asredni/Microgravity-Clinostat/NEMA 17.SLDASM

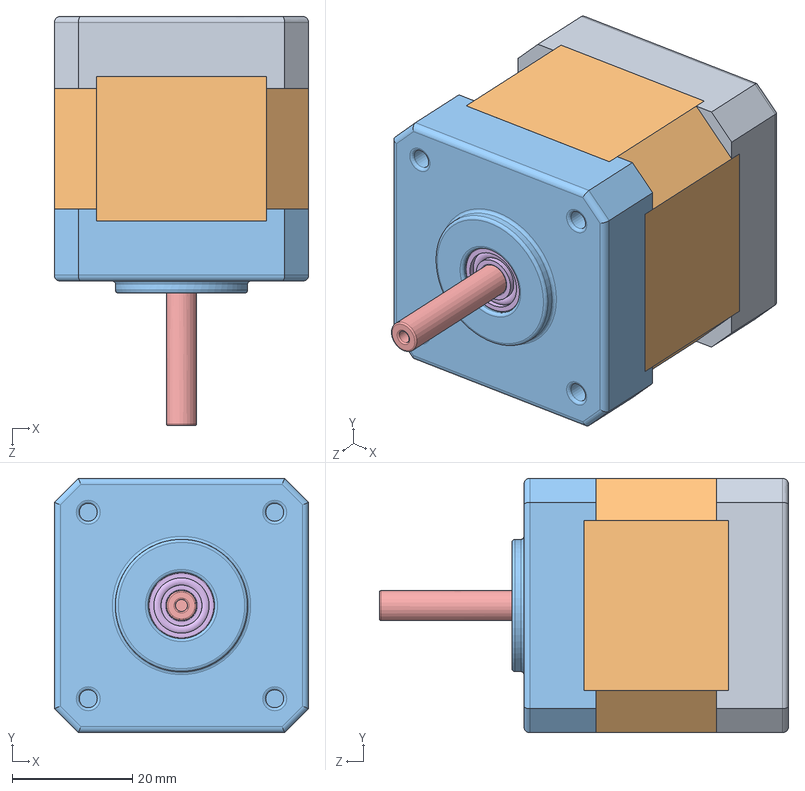
[picture p17: CAD file, 2019-08-01]
NEMA 17.SLDASM
42.3 x 42.3 x 68.0 mm
Base
Cuerpo
Tapa
pan cross head_am x 4
Eje
instrument ball bearing_68_am x 2
