asredni/Microgravity-Clinostat/Montagem1.SLDASM

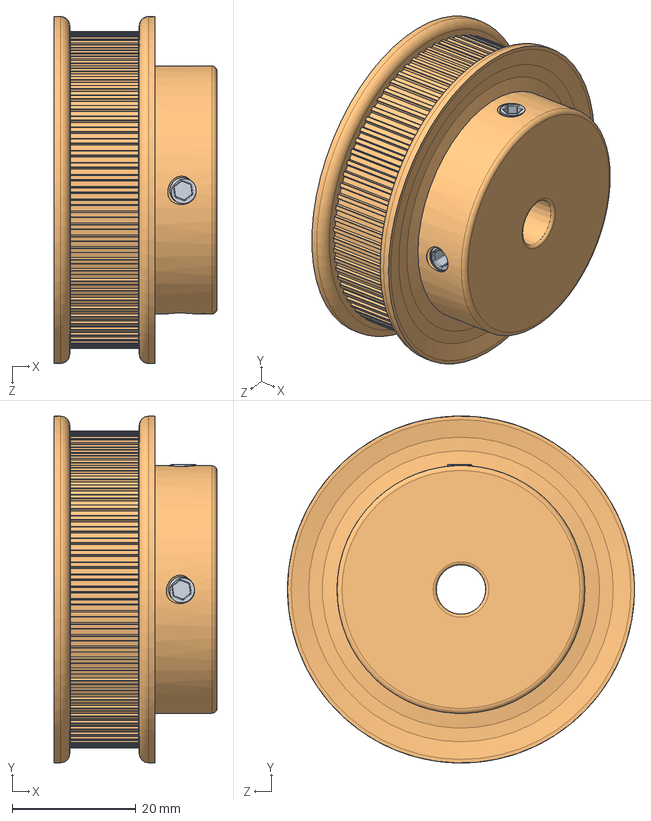
[picture p18: CAD file, 2019-08-01]
Montagem1.SLDASM
26.3 x 56.0 x 56.0 mm
setscrew M5 x 2
PULLEY MXL80 2mm
