asredni/Microgravity-Clinostat/assem semi-semi.SLDASM

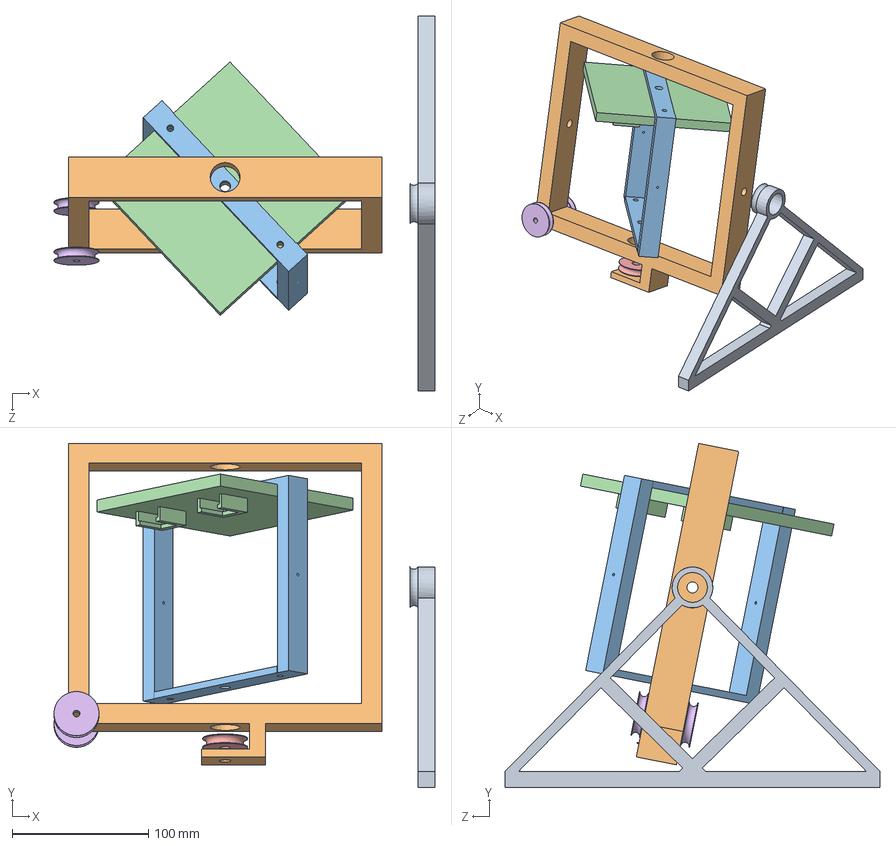
[picture p19: CAD file, 2019-08-01]
assem semi-semi.SLDASM
279.6 x 252.6 x 275.0 mm
Base truss
outer frame 4
inner frame, frame
Inner Frame Plate
27mm o-ring gear big
27mm o-ring gear real x 2
