asredni/Microgravity-Clinostat/Assem semi-final.SLDASM

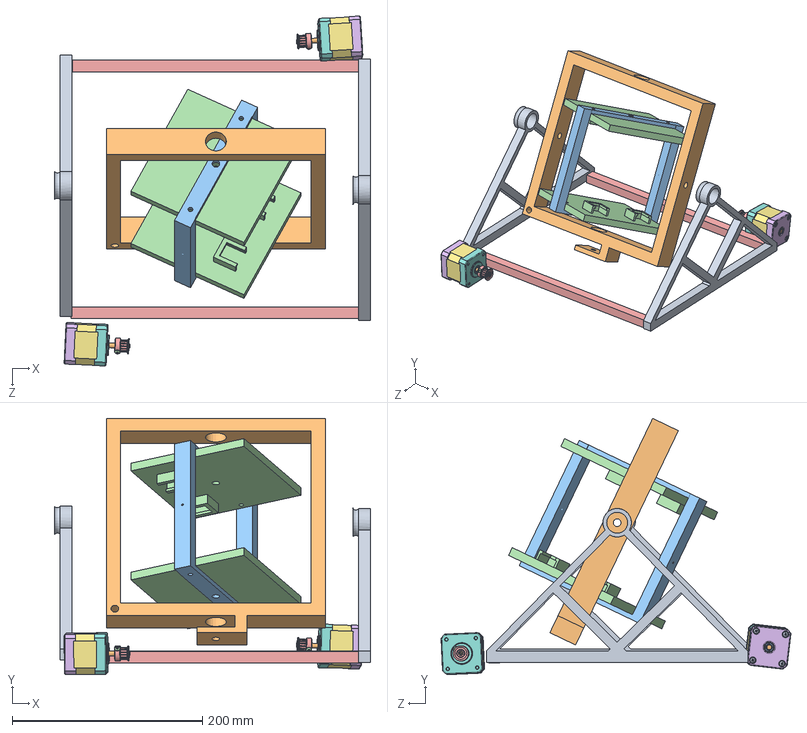
[picture p20: CAD file, 2019-08-01]
Assem semi-final.SLDASM
332.2 x 269.3 x 367.8 mm
Base truss x 2
outer frame 3
inner frame, frame
Inner Frame Plate x 2
outer frame beam x 2
Base x 2
Cuerpo x 2
Tapa x 2
pan cross head_am x 8
Eje x 2
instrument ball bearing_68_am x 4
socket button head cap screw_am x 2
T5 Pulley x 2
