asredni/Microgravity-Clinostat/aseembf.SLDASM

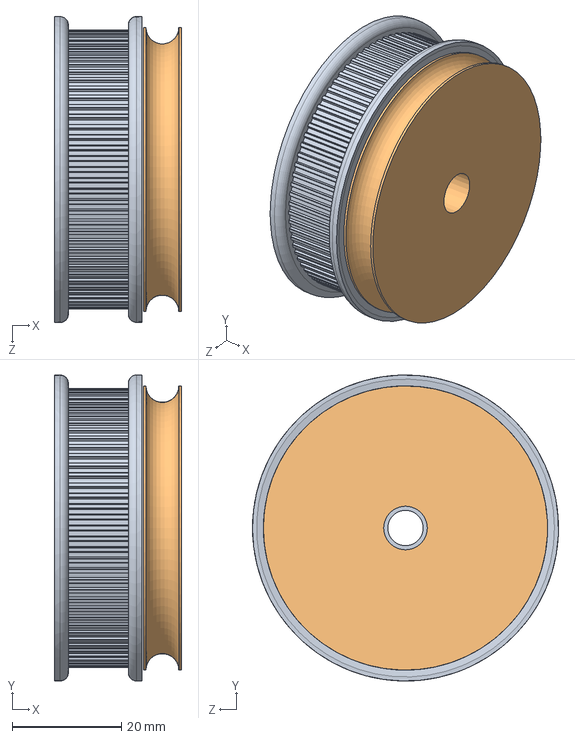
[picture p21: CAD file, 2019-08-01]
aseembf.SLDASM
23.2 x 56.0 x 56.0 mm
Outer gear pulley 4
46mm o-ring gear big
