asredni/Microgravity-Clinostat/assemb 5.SLDASM

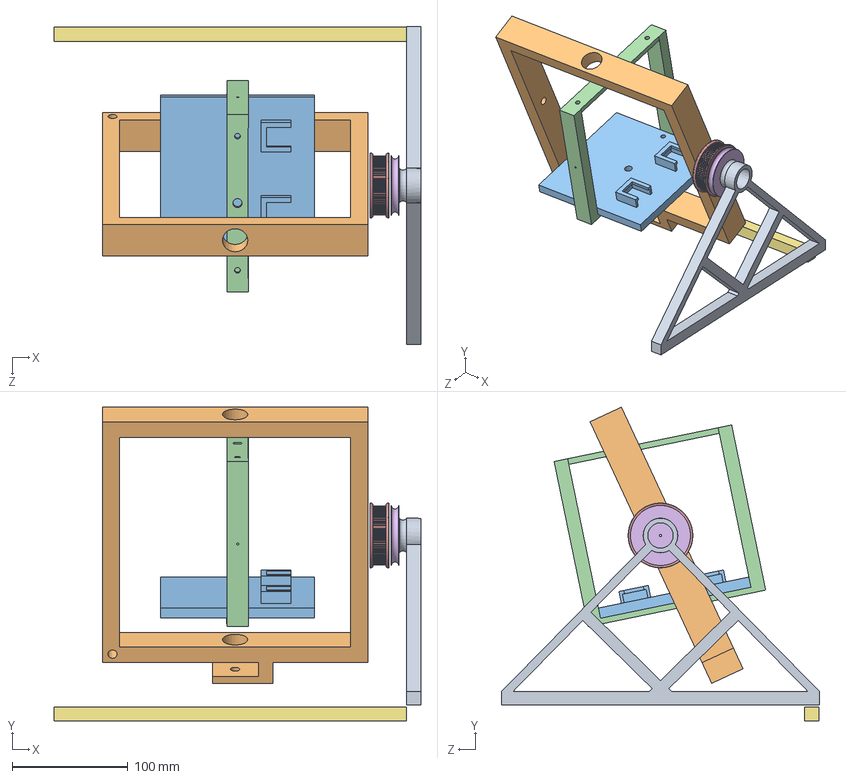
[picture p22: CAD file, 2019-08-01]
assemb 5.SLDASM
317.7 x 271.6 x 275.0 mm
Base truss
outer frame 3
Inner Frame Plate
inner frame, frame
Outer frame pulley 2
46mm o-ring gear (2)
outer base beam
