asredni/Microgravity-Clinostat/assemb 4.SLDASM

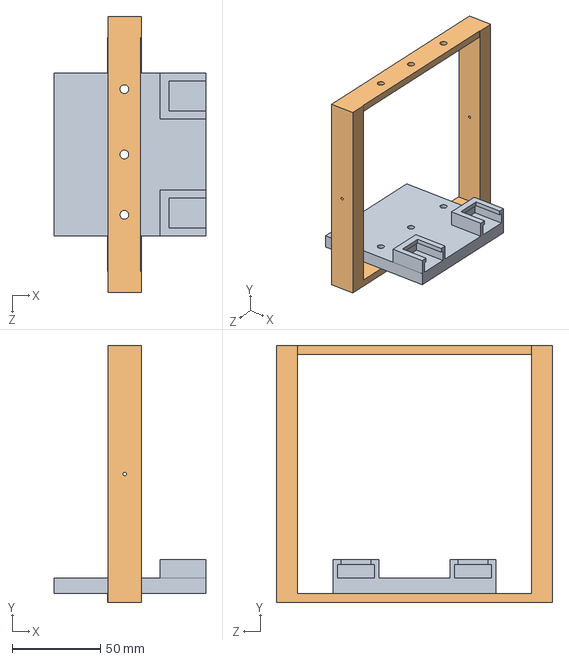
[picture p23: CAD file, 2019-08-01]
assemb 4.SLDASM
86.1 x 146.0 x 157.0 mm
Inner Frame Plate 2
inner frame, frame, holes 2
