asredni/Microgravity-Clinostat/ewg.SLDASM

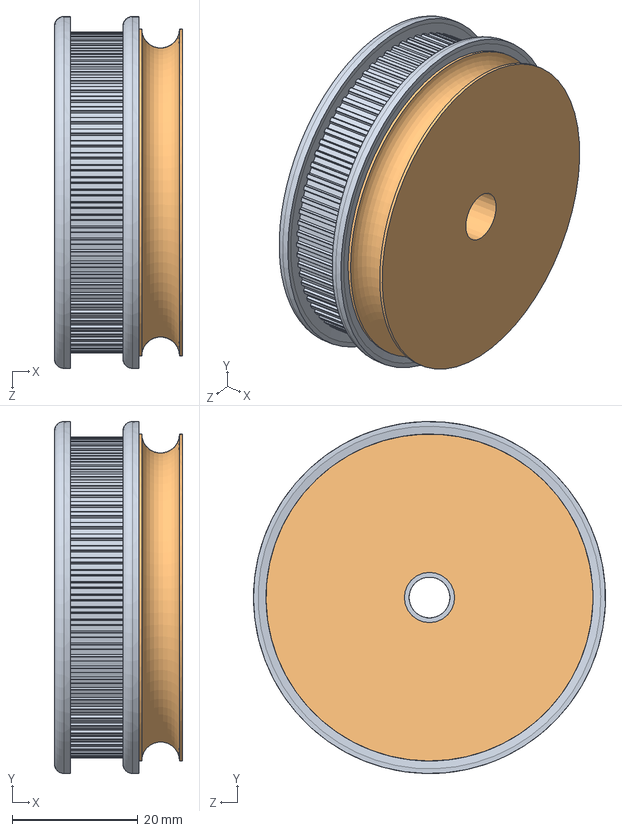
[picture p24: CAD file, 2019-08-01]
ewg.SLDASM
20.4 x 56.0 x 56.0 mm
outer gear small
46mm o-ring gear big
