asredni/Microgravity-Clinostat/Assem2.SLDASM

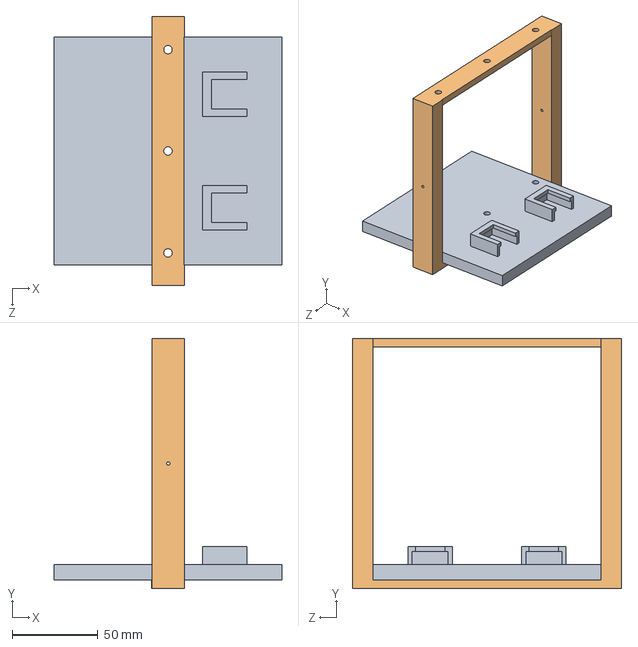
[picture p25: CAD file, 2019-08-01]
Assem2.SLDASM
133.0 x 146.0 x 157.0 mm
Inner Frame Plate
inner frame, frame
