asredni/Microgravity-Clinostat/engclamp.SLDASM

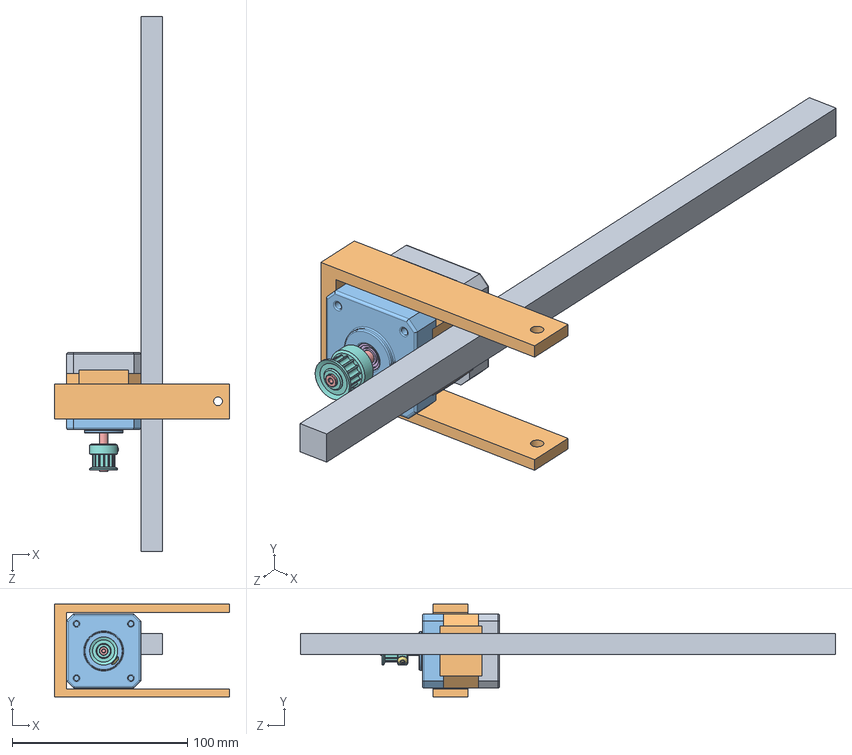
[picture p26: CAD file, 2019-08-01]
engclamp.SLDASM
100.0 x 53.0 x 305.0 mm
Base
Cuerpo
Tapa
pan cross head_am x 4
Eje
instrument ball bearing_68_am x 2
socket button head cap screw_am
T5 Pulley
outer frame beam
engine clamp
