asredni/Microgravity-Clinostat/RPM assemb 4.SLDASM

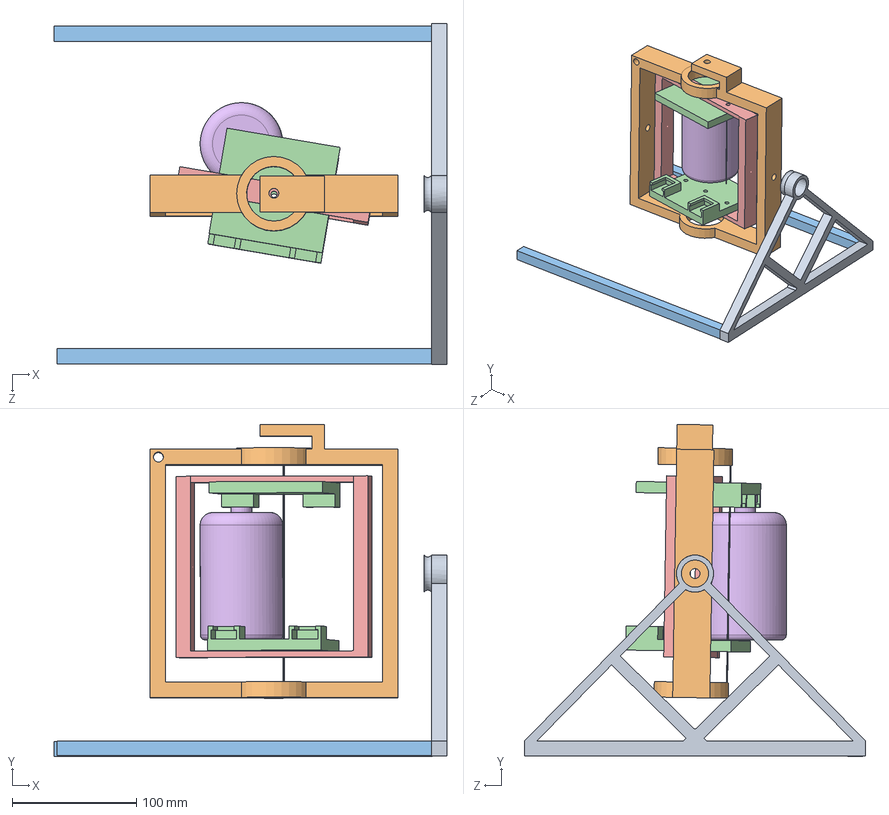
[picture p27: CAD file, 2019-08-01]
RPM assemb 4.SLDASM
316.7 x 267.7 x 275.0 mm
Base truss
outer frame 2
outer frame beam x 2
Inner Frame Plate 2 x 2
inner frame, frame, holes 2
sciencebottle (1)
