asredni/Microgravity-Clinostat/Outer Frame Pulley Edited.SLDASM

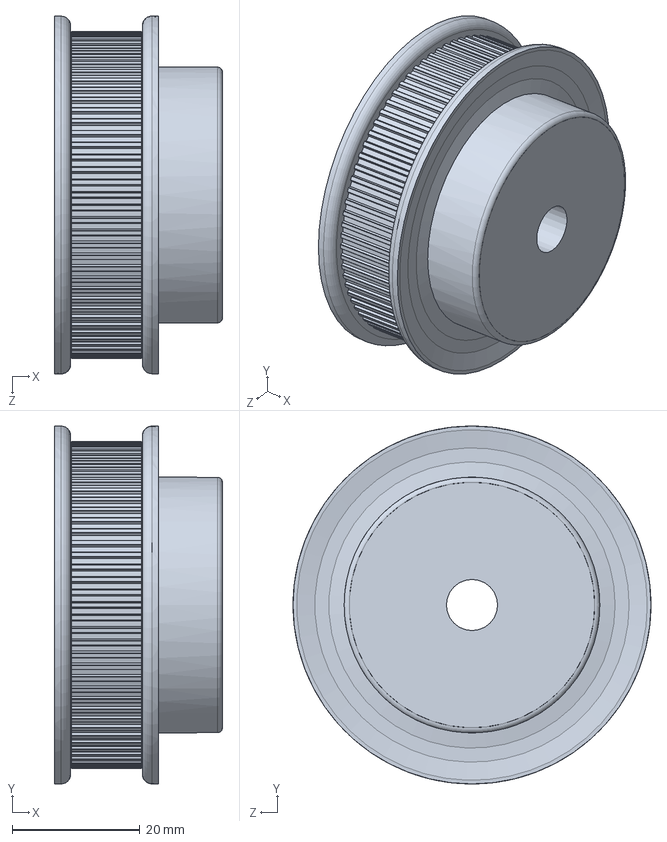
[picture p28: CAD file, 2019-08-01]
Outer Frame Pulley Edited.SLDASM
26.3 x 56.0 x 56.0 mm
