asredni/Microgravity-Clinostat/gear merge.SLDASM

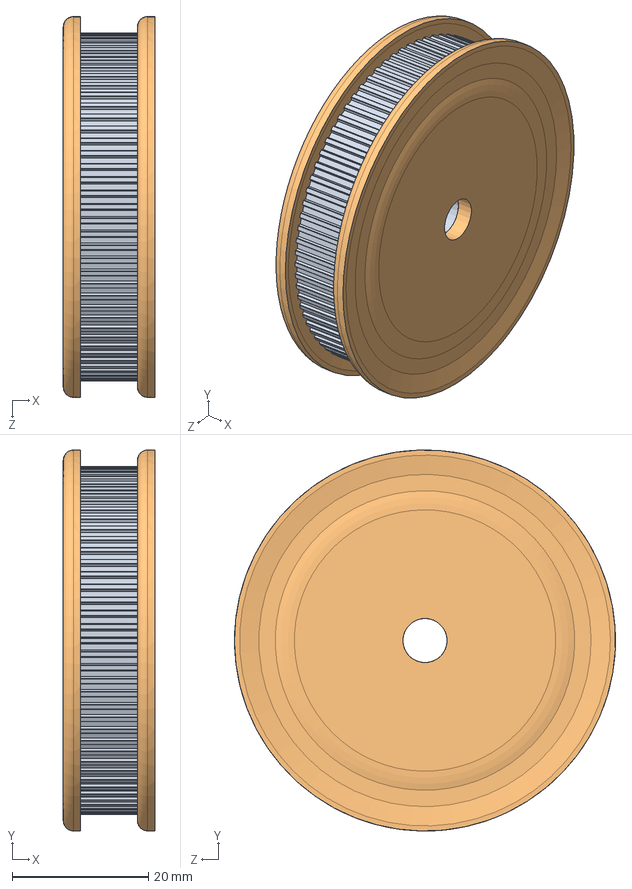
[picture p29: CAD file, 2019-08-01]
gear merge.SLDASM
13.4 x 56.0 x 56.0 mm
teeth
Outer plate x 2
