asredni/Microgravity-Clinostat/Eje.SLDPRT

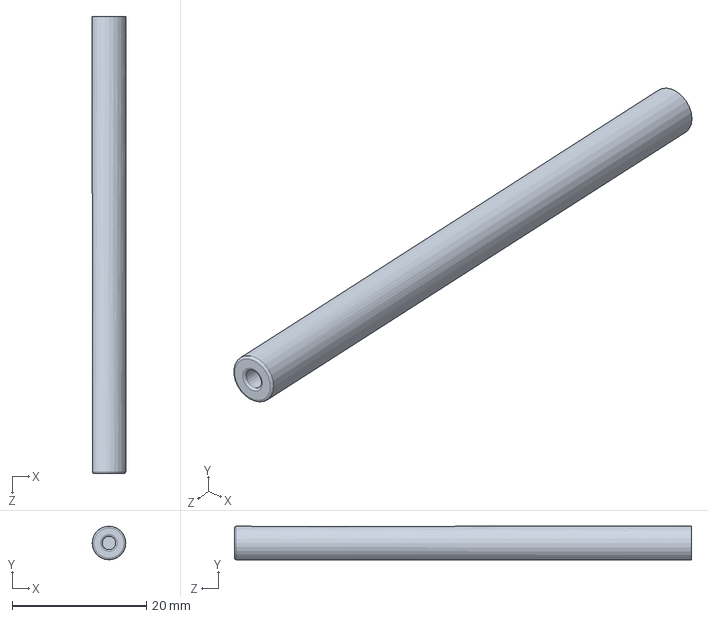
[picture p30: CAD file, 2019-08-01]
Eje.SLDPRT
5.00 x 5.00 x 68.0 mm
