asredni/Microgravity-Clinostat/Tapa.SLDPRT

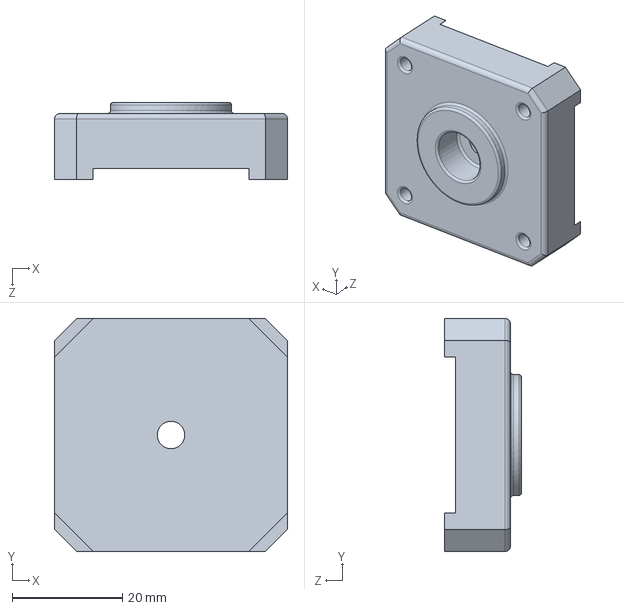
[picture p31: CAD file, 2019-08-01]
Tapa.SLDPRT
42.3 x 42.3 x 14.0 mm
