asredni/Microgravity-Clinostat/T5 Pulley.SLDPRT

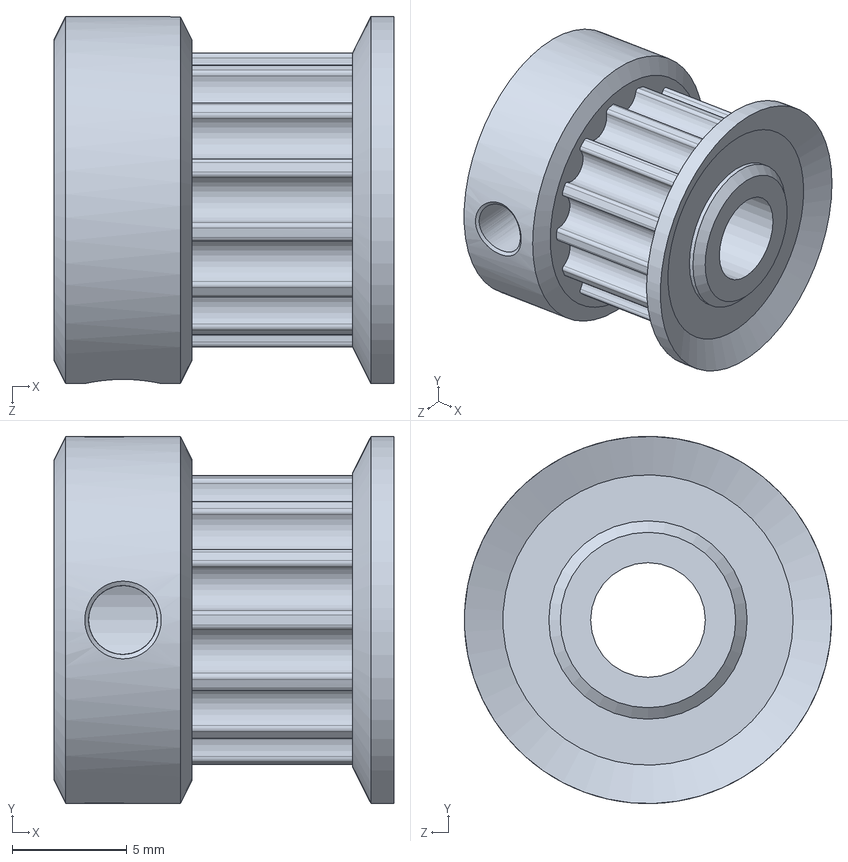
[picture p32: CAD file, 2019-08-01]
T5 Pulley.SLDPRT
14.8 x 16.0 x 16.0 mm
