asredni/Microgravity-Clinostat/Cuerpo.SLDPRT

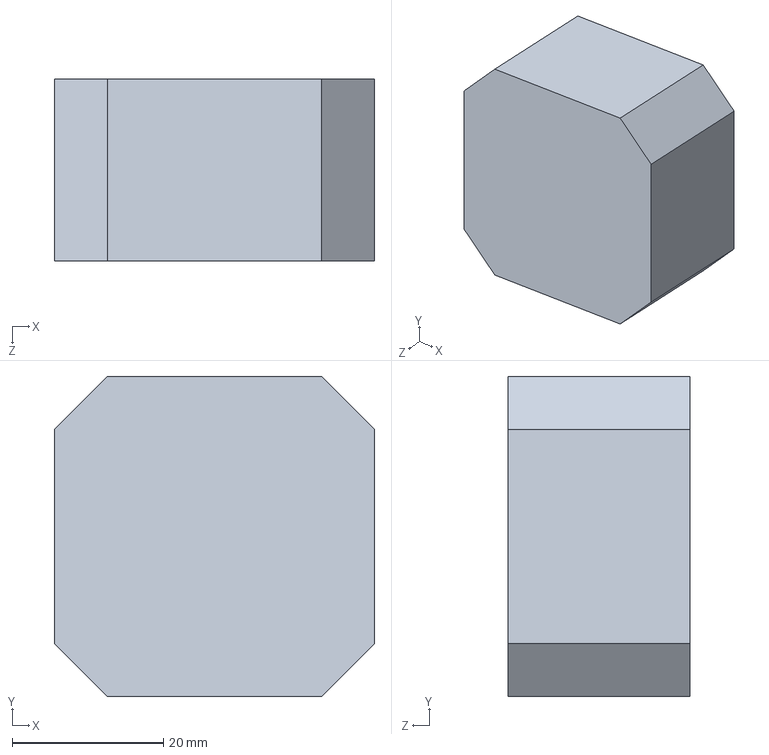
[picture p33: CAD file, 2019-08-01]
Cuerpo.SLDPRT
42.3 x 42.3 x 24.0 mm
