asredni/Microgravity-Clinostat/Base.SLDPRT

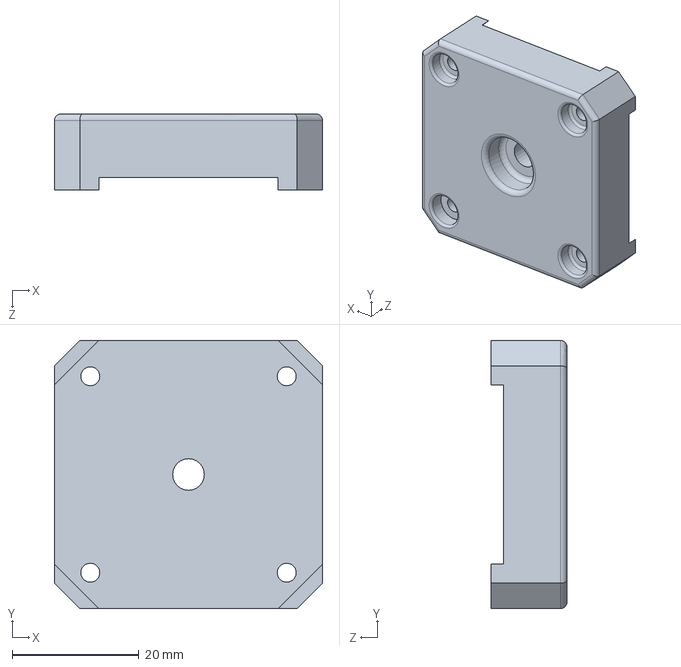
[picture p34: CAD file, 2019-08-01]
Base.SLDPRT
42.3 x 42.3 x 12.0 mm
