asredni/Microgravity-Clinostat/outer fram side 1.SLDPRT

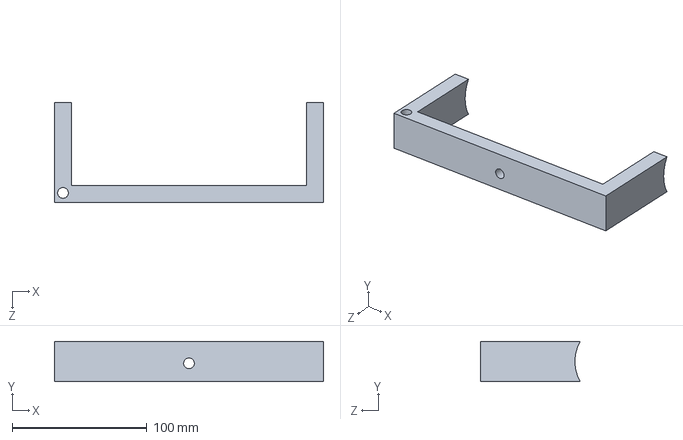
[picture p35: CAD file, 2019-08-01]
outer fram side 1.SLDPRT
200.0 x 30.0 x 74.0 mm
