asredni/Microgravity-Clinostat/Outer gear pulley 4.SLDPRT

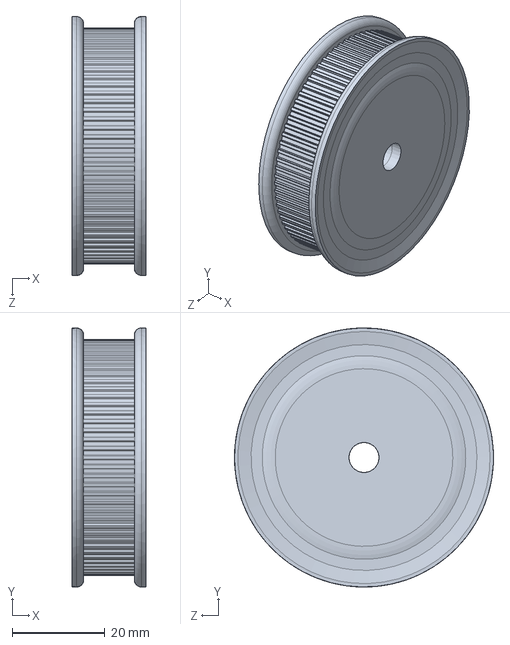
[picture p36: CAD file, 2019-08-01]
Outer gear pulley 4.SLDPRT
16.1 x 56.0 x 56.0 mm
