asredni/Microgravity-Clinostat/inner frame, frame.SLDPRT

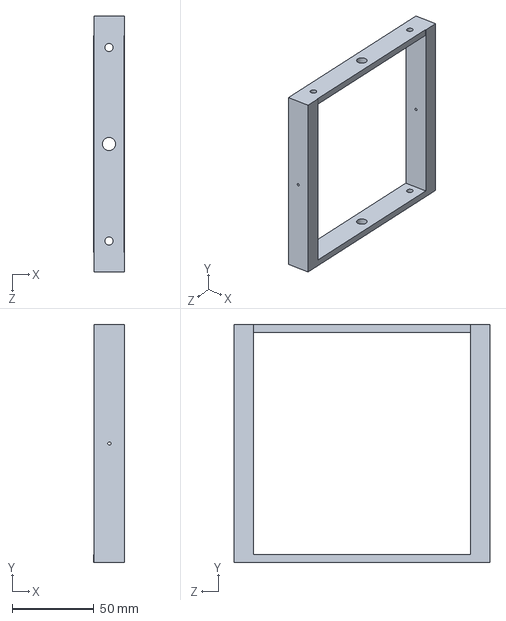
[picture p37: CAD file, 2019-08-01]
inner frame, frame.SLDPRT
19.3 x 146.0 x 157.0 mm
