asredni/Microgravity-Clinostat/46mm o-ring gear (2).SLDPRT

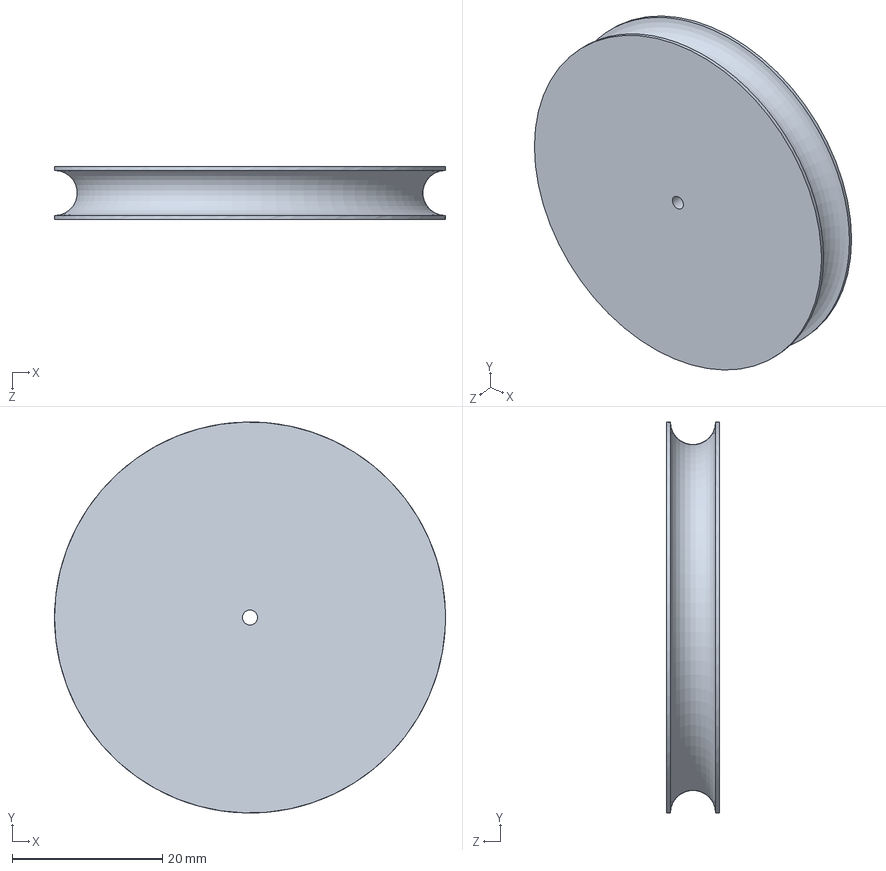
[picture p38: CAD file, 2019-08-01]
46mm o-ring gear (2).SLDPRT
52.0 x 52.0 x 7.00 mm
