asredni/Microgravity-Clinostat/outer fram side 2.SLDPRT

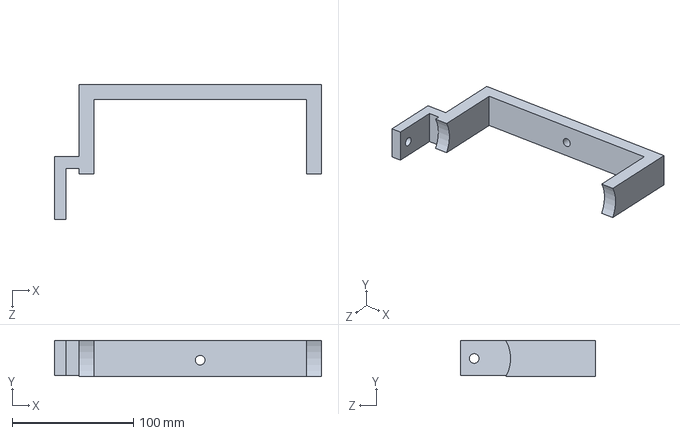
[picture p39: CAD file, 2019-08-01]
outer fram side 2.SLDPRT
220.0 x 30.0 x 111.4 mm
