asredni/Microgravity-Clinostat/Inner Frame Plate 2.SLDPRT

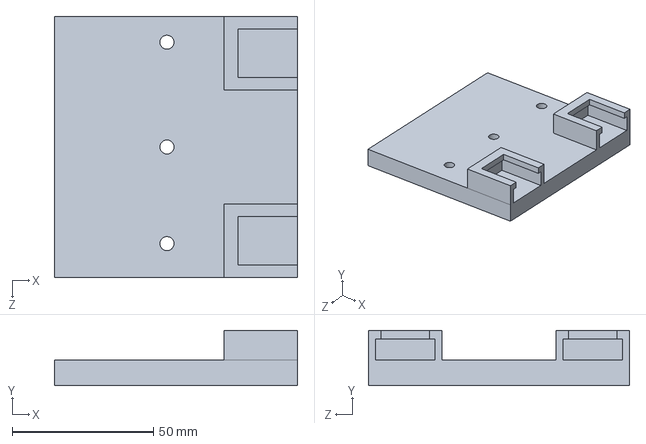
[picture p40: CAD file, 2019-08-01]
Inner Frame Plate 2.SLDPRT
86.1 x 19.5 x 92.5 mm
