asredni/Microgravity-Clinostat/Inner Frame Plate.SLDPRT

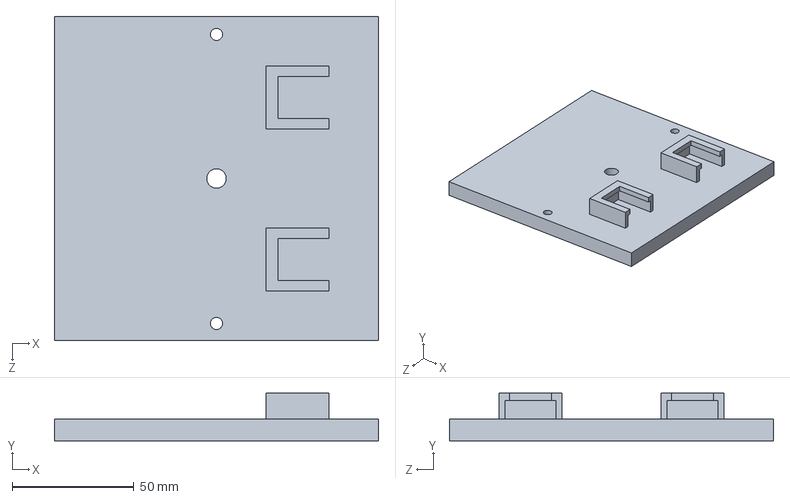
[picture p41: CAD file, 2019-08-01]
Inner Frame Plate.SLDPRT
133.0 x 19.5 x 133.0 mm
