asredni/Microgravity-Clinostat/teeth.SLDPRT

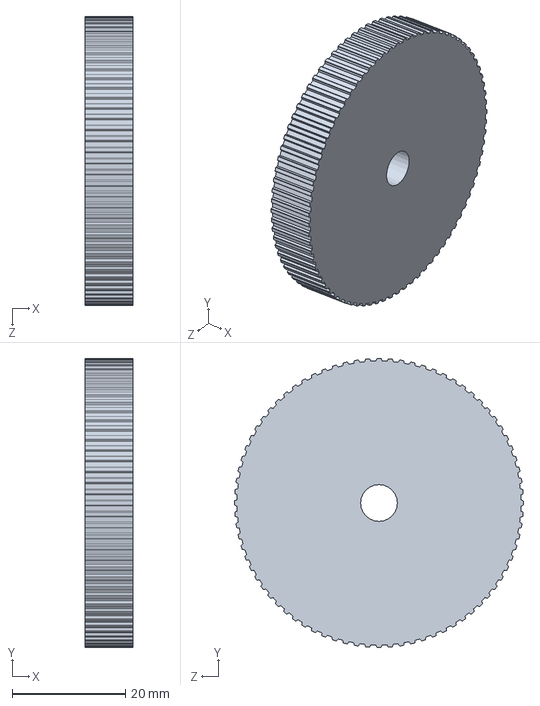
[picture p42: CAD file, 2019-08-01]
teeth.SLDPRT
8.45 x 51.1 x 51.1 mm
