asredni/Microgravity-Clinostat/27mm o-ring gear real.SLDPRT

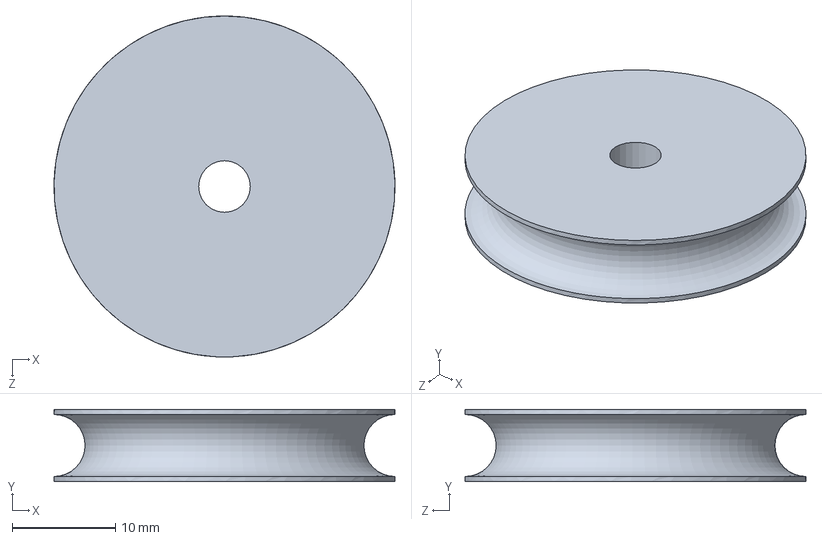
[picture p43: CAD file, 2019-08-01]
27mm o-ring gear real.SLDPRT
33.0 x 7.00 x 33.0 mm
