asredni/Microgravity-Clinostat/outer frame 2.SLDPRT

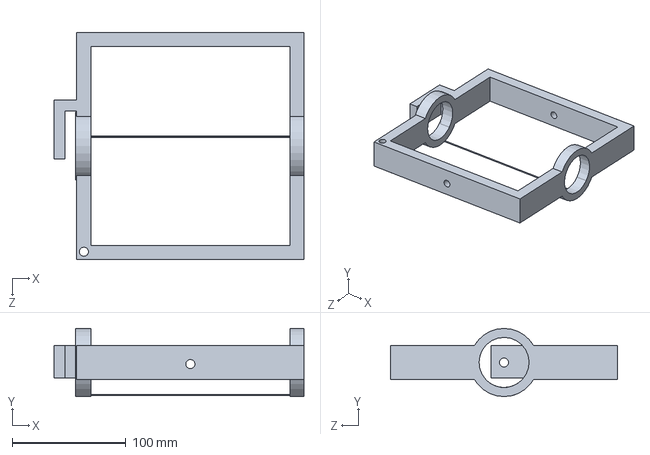
[picture p44: CAD file, 2019-08-01]
outer frame 2.SLDPRT
220.0 x 60.0 x 200.0 mm
