asredni/Microgravity-Clinostat/engine clamp.SLDPRT

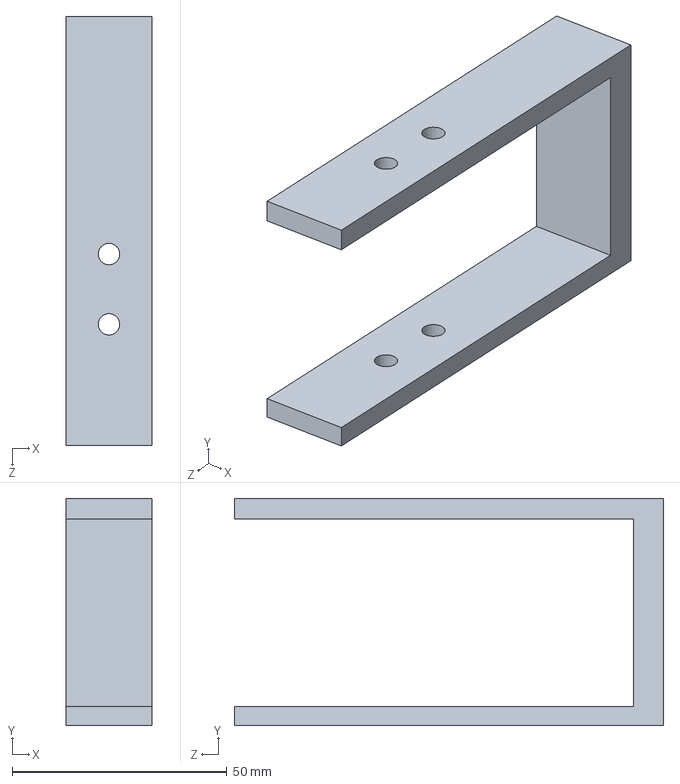
[picture p45: CAD file, 2019-08-01]
engine clamp.SLDPRT
20.0 x 53.0 x 100.0 mm
