asredni/Microgravity-Clinostat/outer frame 4.SLDPRT

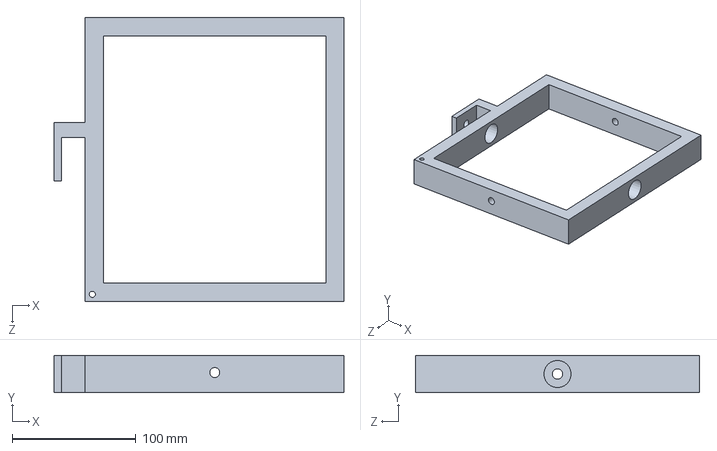
[picture p46: CAD file, 2019-08-01]
outer frame 4.SLDPRT
234.6 x 30.0 x 230.0 mm
