asredni/Microgravity-Clinostat/outer fram ring.SLDPRT

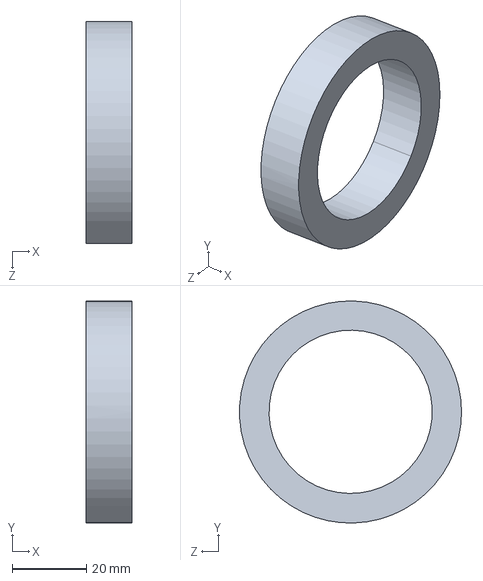
[picture p47: CAD file, 2019-08-01]
outer fram ring.SLDPRT
12.5 x 60.0 x 60.0 mm
