asredni/Microgravity-Clinostat/Outer plate.SLDPRT

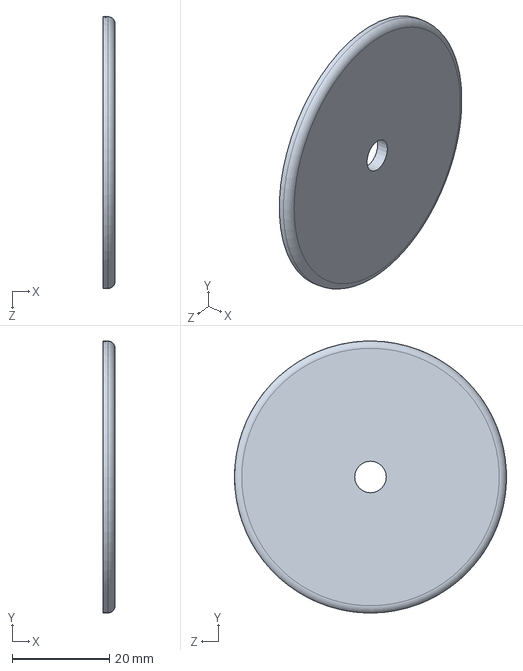
[picture p48: CAD file, 2019-08-01]
Outer plate.SLDPRT
2.55 x 56.0 x 56.0 mm
