asredni/Microgravity-Clinostat/engine clamp 2.SLDPRT

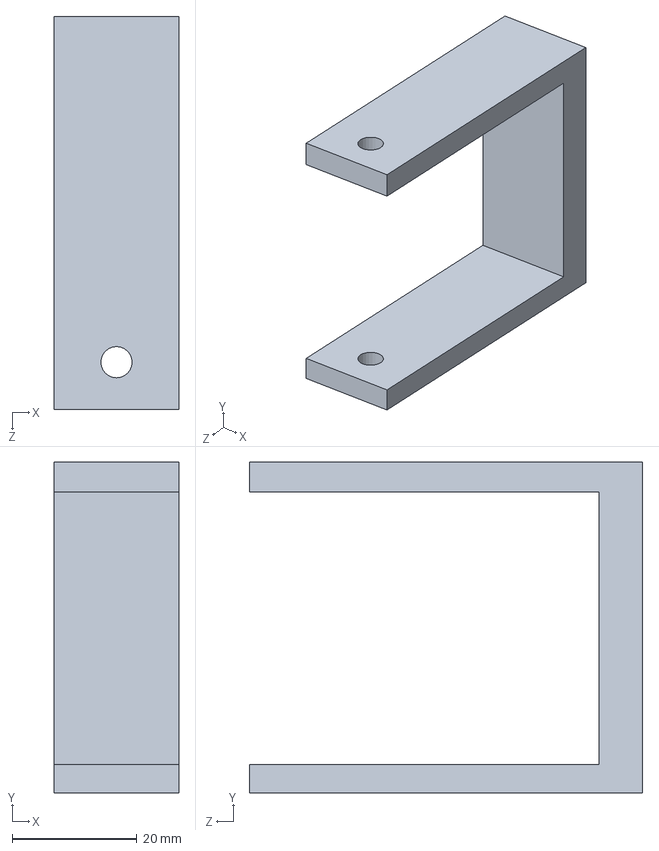
[picture p49: CAD file, 2019-08-01]
engine clamp 2.SLDPRT
20.0 x 53.0 x 63.0 mm
