asredni/Microgravity-Clinostat/outer frame beam.SLDPRT

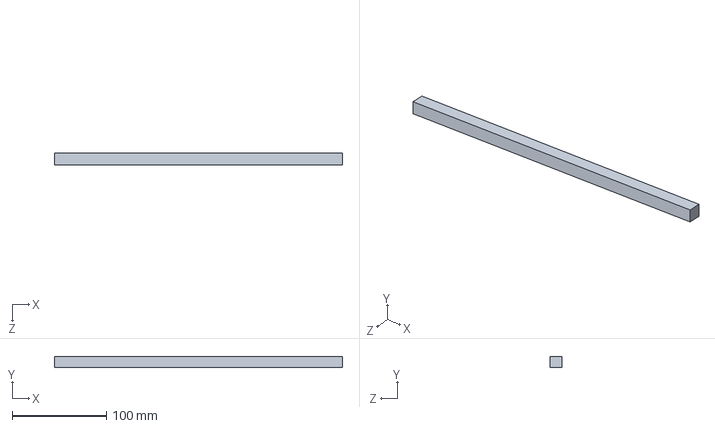
[picture p50: CAD file, 2019-08-01]
outer frame beam.SLDPRT
305.0 x 12.0 x 12.5 mm
