asredni/Microgravity-Clinostat/outer frame 3.SLDPRT

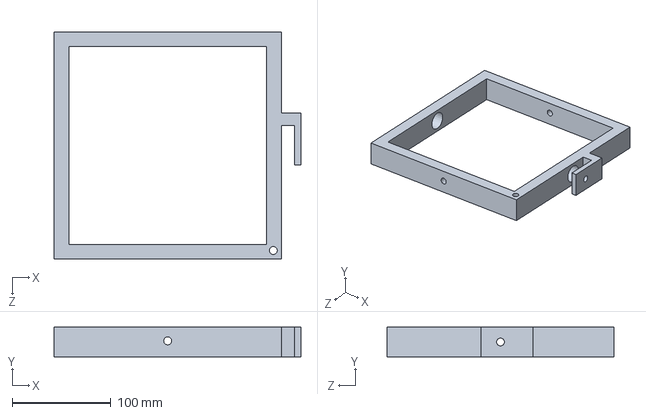
[picture p51: CAD file, 2019-08-01]
outer frame 3.SLDPRT
249.8 x 30.0 x 230.0 mm
