asredni/Microgravity-Clinostat/sciencebottle (1).SLDPRT

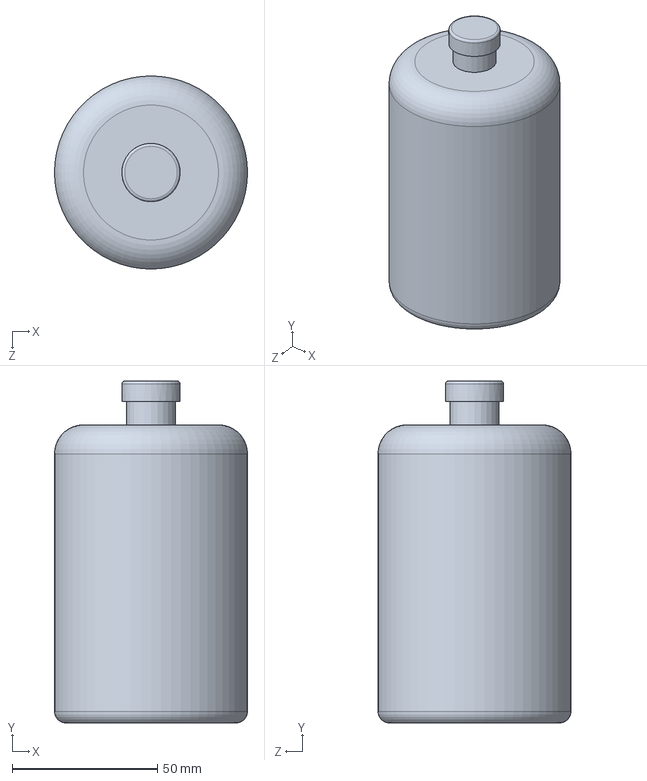
[picture p52: CAD file, 2019-08-01]
sciencebottle (1).SLDPRT
66.5 x 117.8 x 66.5 mm
