asredni/Microgravity-Clinostat/Base truss.SLDPRT

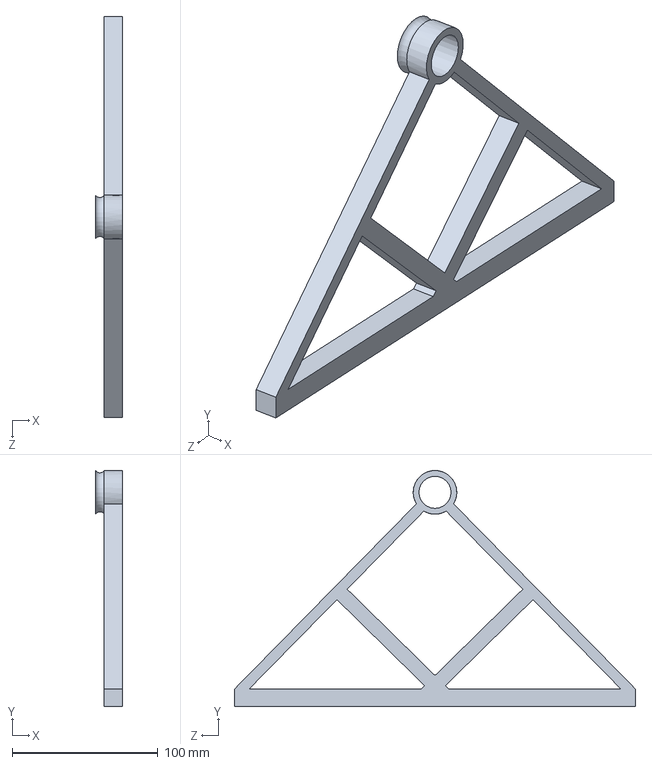
[picture p53: CAD file, 2019-08-01]
Base truss.SLDPRT
18.5 x 161.9 x 275.0 mm
