asredni/Microgravity-Clinostat/(list of files, cad)

Other CAD files:
Outer Frame Pulley.SLDASM
PULLEY MXL80 2mm.SLDPRT
outer gear small.SLDPRT
46mm o-ring gear big.SLDPRT
Outer Frame Pulley 3.SLDPRT
inner frame, frame, holes 2.SLDPRT
Outer frame pulley 2.SLDPRT
27mm o-ring gear (3).SLDPRT
27mm o-ring gear big.SLDPRT
Outer frame gear merge.SLDPRT
outer base beam.SLDPRT
Outer Frame.SLDPRT
inner frame, frame, holes.SLDPRT
NEMA 17 with T5 Pulley.SLDASM
NEMA 17 with T5 Pulley.STP
NEMA 17.STL
Outer Frame Pulley Edited.SLDPRT
Outer frame pulley 2.STL
gear merge.SLDPRT
gear merge.STL
outer gear small.STL
setscrew M5.SLDPRT
