asredni/Microgravity-Clinostat/Lab certificate biosafety.pdf

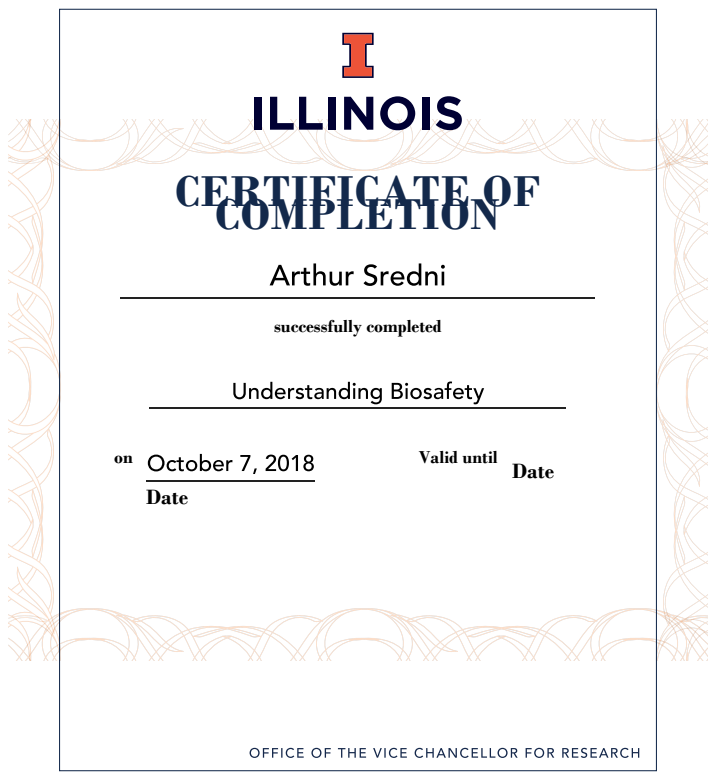
[picture p54: page 1]
successfully completed; Date; Valid until

CERTIFICATE OF COMPLETION
