asredni/Microgravity-Clinostat/Lan certificate.pdf

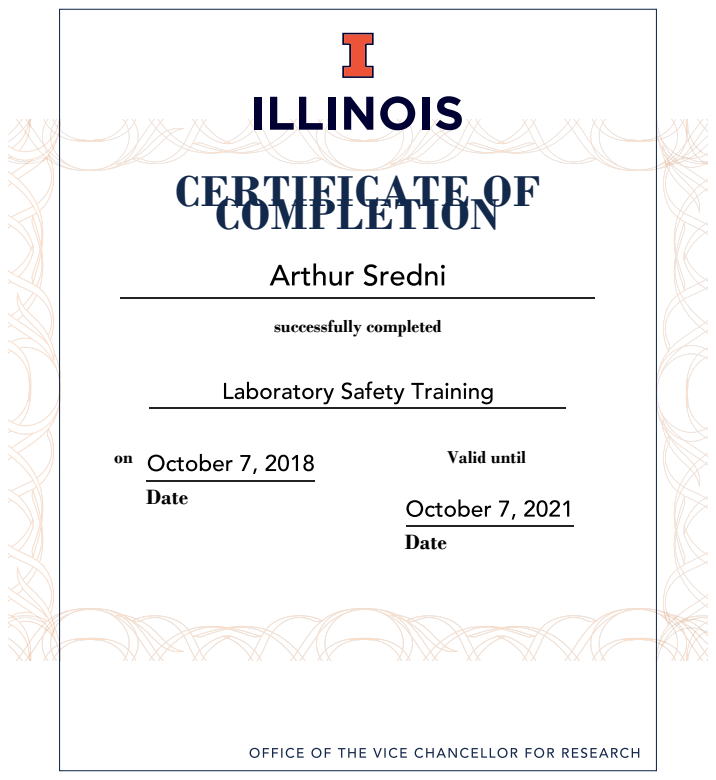
[picture p55: page 1]
successfully completed; Date; Valid until

CERTIFICATE OF COMPLETION
